Mihirbhati18/rover-smart-car/active_view_frames/bottle-centered-2026-10-10/raw-view-1.jpg

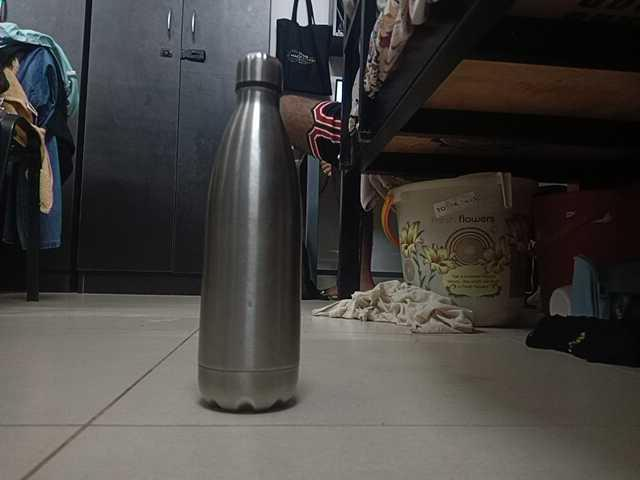
active_view_frames/bottle-centered-2026-10-10/raw-view-1.jpg
